striso/striso_duet/README.md

# Striso duet

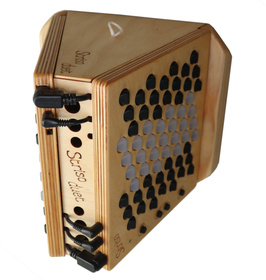
[picture p1: img/duet_complete.jpg]
Striso duet


The Striso duet – a portable instrument based on the Striso board, inspired by concertina, bandoneon and accordion. This repository contains the design files and assembly instructions. For more information on the instrument see the https://www.striso.org/the-striso-duet/.

To encourage the design of custom instruments based on the Striso board the design files of the Striso duet are released as open source under the CERN Open Hardware Licence. We'd love to hear about your build experience, modifications or custom designs.

## Design
The duet is a wooden body on which two Striso boards can be mounted to play with two hands in a concertina/bandoneon/accordion style. The body is made from 3mm birch multiplex and the design is cut and engraved with a laser cutter.

The laser cutting design is made in [Inkscape](www.inkscape.org), and is currently optimized for cutting almost 4 duets out of a 67x67cm 3mm multiplex board. For cutting one duet you should reposition the parts. The black lines are cut, the blue lines are engraved, and the green lines are engraved out of focus, to have thicker lines.

The PCBs are designed in EasyEDA. (Normally I'd use KiCAD, but for these simple PCBs I was drawn to EasyEDA for its integrated fabrication service and related parts library).

## Assembly guide
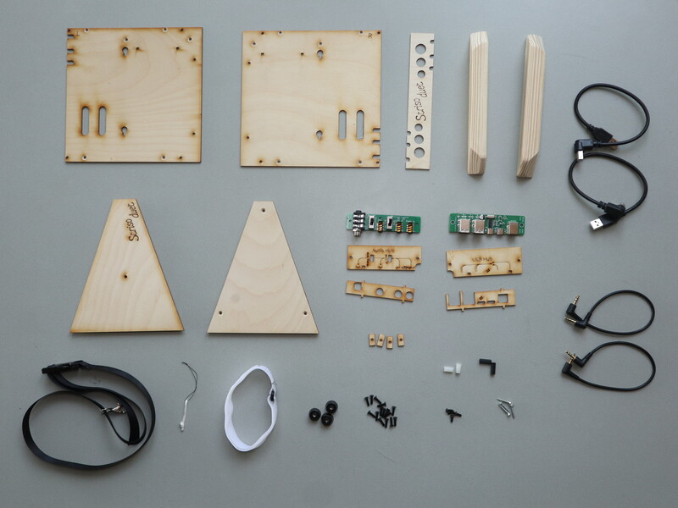
[picture p2: img/duet_kit.jpg]
Duet parts


#### Part list:
- Lasercut parts: 2 sides, front, top, bottom, USB and audio PCB covers, PCB spacers. Top and bottom parts consist of 3 layers glued together.
- Palm rests: 22x30x194mm wood with chamfered corners and rounded edge
- Audio mixer hub PCB
- USB hub PCB
- 3x rubber feet (with 3mm flange nut inside)
- 15x M3 12mm countersunk hex screw
- 4x M3 8mm mushroom hex screw
- 2x M3 20mm standoff
- 2x M3 12mm standoff
- 4x 3mm wood screw
- 8x M3 square nut (already inserted in top and bottom panels while glueing) (hex nuts probably work fine too)
- 2x 20cm right angled USB-B cable
- 2x 20cm right angled 3.5mm jack cable
- Strap connection loop
- Neck strap
- Velcro strap for holding speaker or powerbank

#### Assembly steps
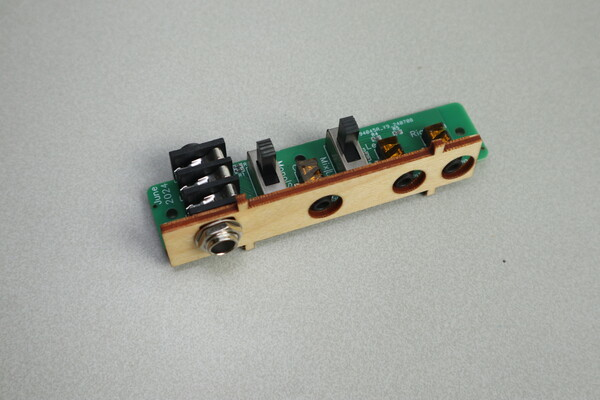
[picture p3: img/1.jpg]
\
Put the front panel on the audio PCB

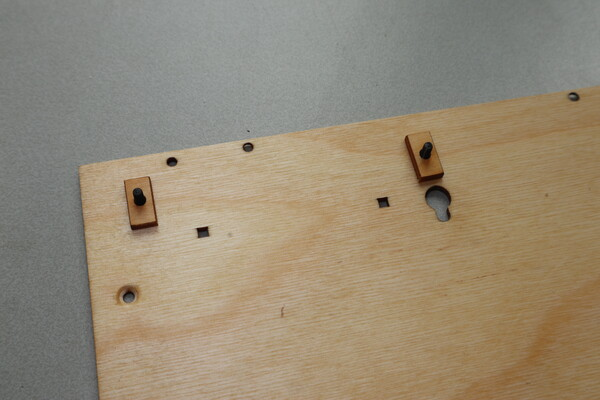
[picture p4: img/3.jpg]
\
Put 2 screws through the left side and add PCB spacers

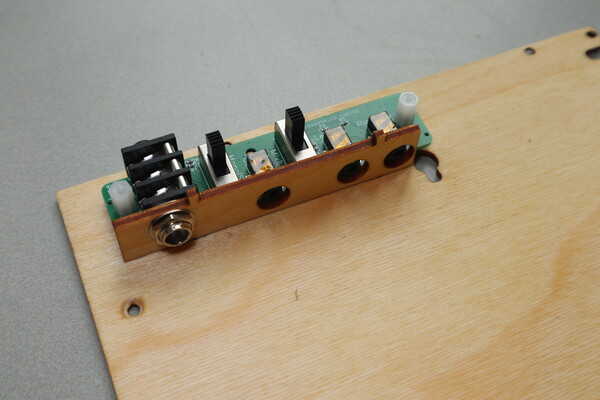
[picture p5: img/4.jpg]
\
Put the audio PCB assembly on top and fix it with 12mm standoffs

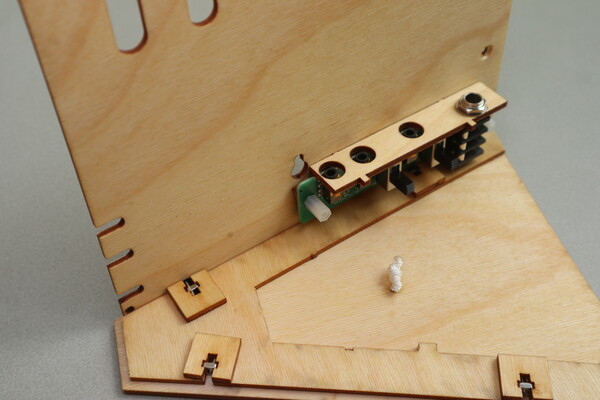
[picture p6: img/5.jpg]
\
Attach the top panel with 2 screws

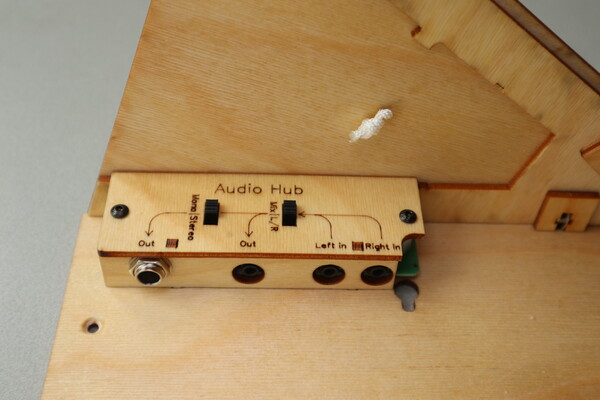
[picture p7: img/6.jpg]
\
Put the top panel on the audio PCB and fix with two M3 mushroom screws

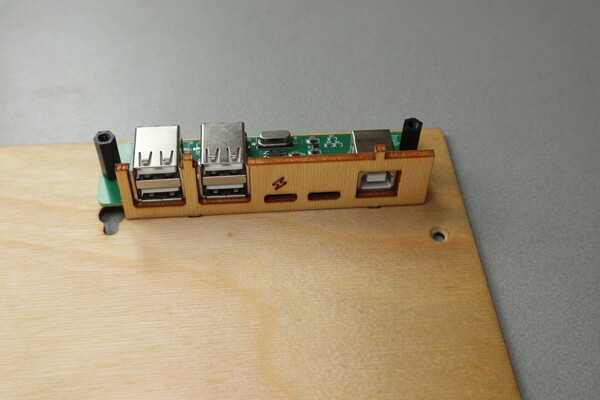
[picture p8: img/7.jpg]
 \
Repeat these steps for the USB PCB on the other side

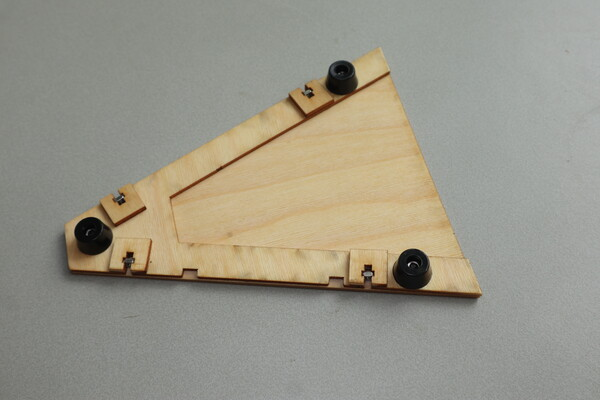
[picture p9: img/9.jpg]
\
Attach the rubber feet with 3 screws

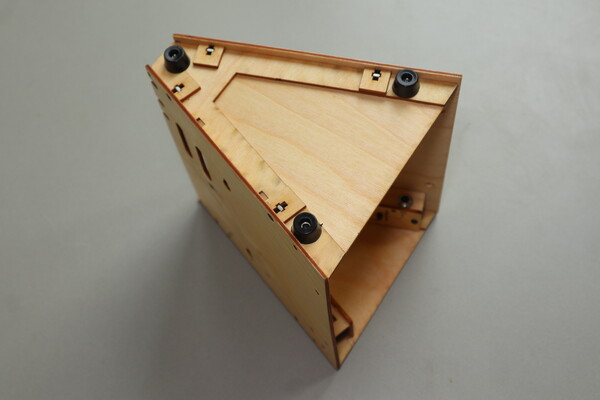
[picture p10: img/10.jpg]
\
Attach the bottom panel with 4 screws

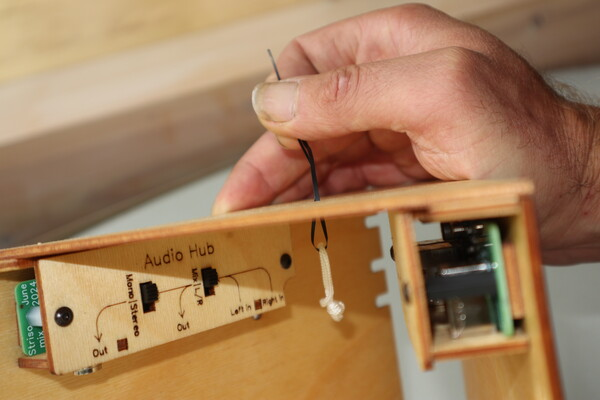
[picture p11: img/11.jpg]
 \
Pull the neck strap loop trough the top hole with a thin thread

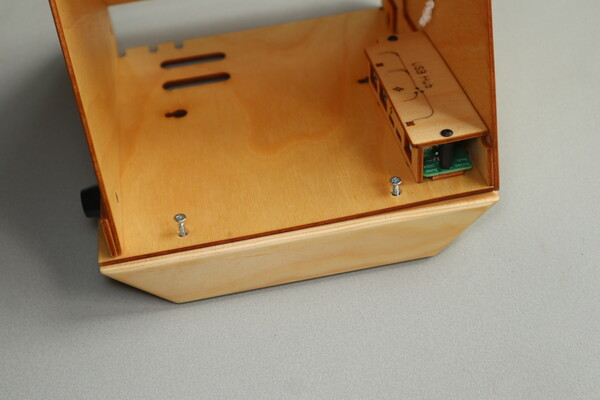
[picture p12: img/13.jpg]
\
Attach the palm rests with the wood screws

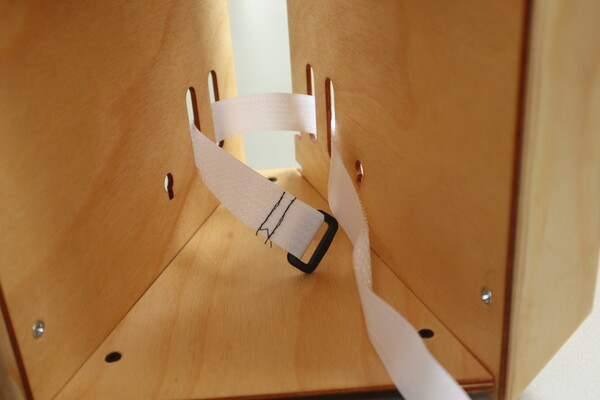
[picture p13: img/14.jpg]
\
Put the velcro strap through the slits

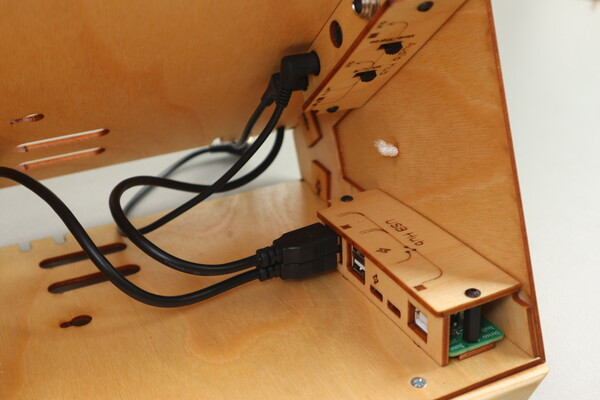
[picture p14: img/15.jpg]
\
Put the USB and audio cable in the hubs

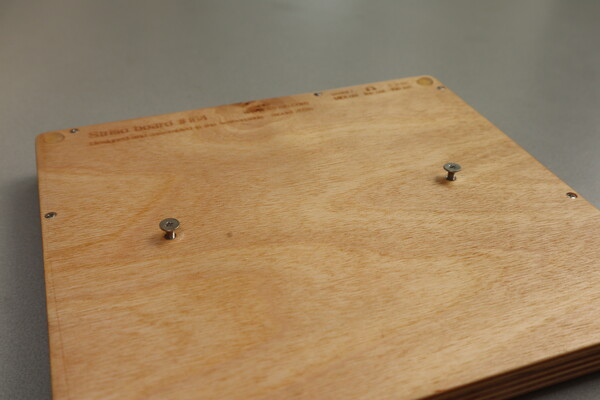
[picture p15: img/17.jpg]
\
Loosen the mounting screws on the back of the Striso board. Be careful to not push too hard on the loosened screws, otherwise the nuts can go inside the Striso board!

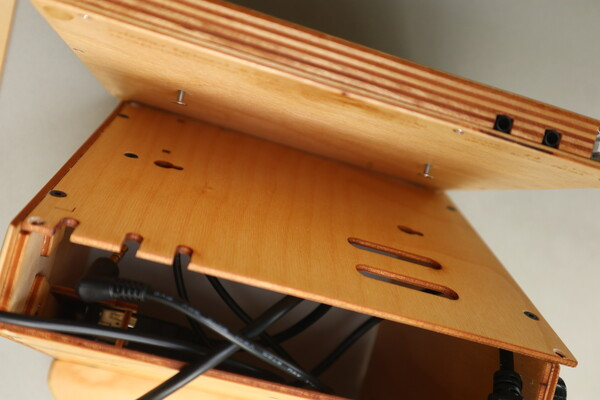
[picture p16: img/18.jpg]
\
Slide them into the keyholes and tighten them with a small philips screwdriver (PH1) (or just a bit in a bitholder)

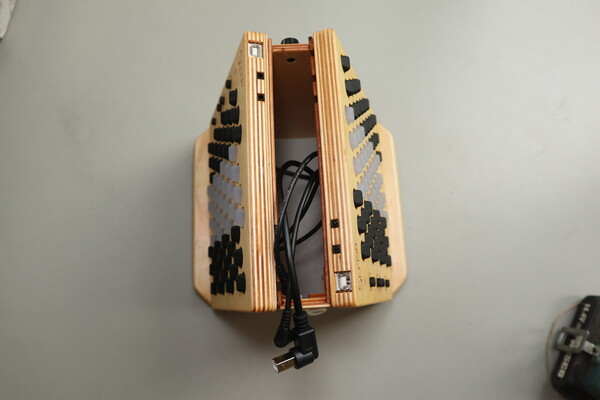
[picture p17: img/19.jpg]
\
Repeat for the second Striso board

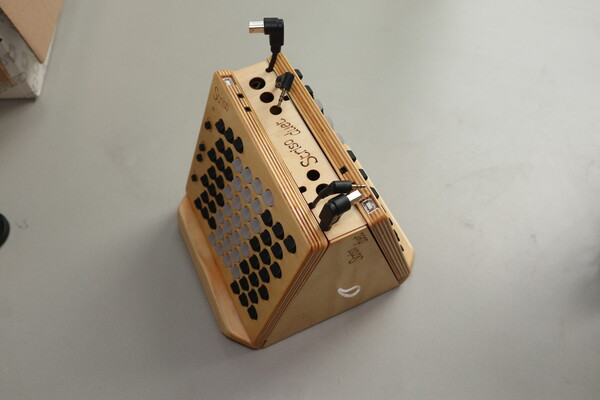
[picture p18: img/20.jpg]
\
Put the front into place with the cables through the holes

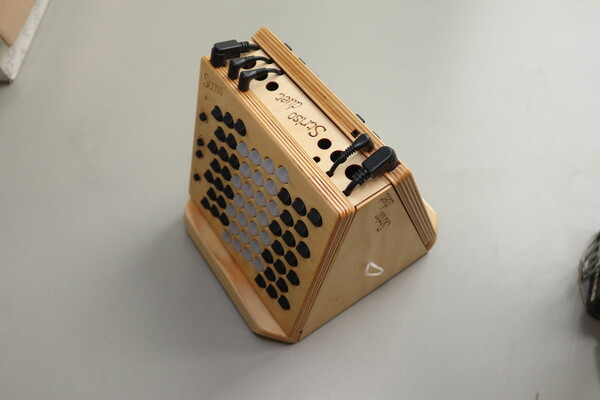
[picture p19: img/21.jpg]
\
Insert the cables in the Striso boards, this also holds the front in place. (In this picture the alternative audio routing is used)

Good luck!
