striso/striso_duet/img/8.jpg

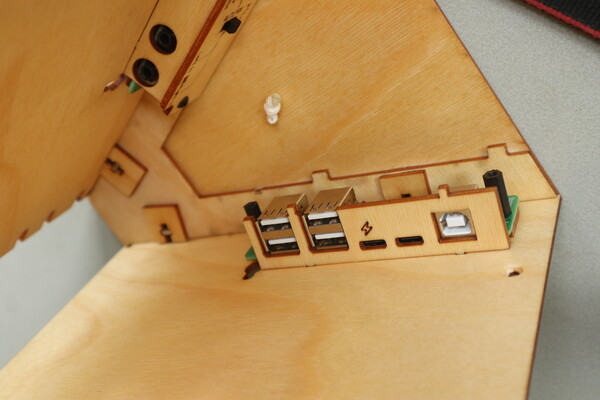
img/8.jpg
