striso/striso_duet/img/12.jpg

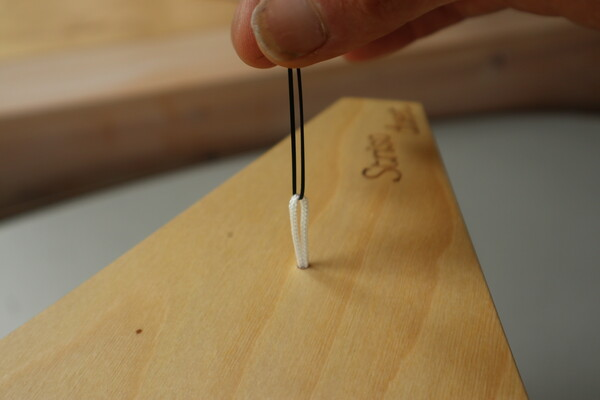
img/12.jpg
