striso/striso_duet/(list of files, drawings)

Other design files:
pcb/Striso_audio_mixer.epro
pcb/Striso_USB_hub.epro
