striso/striso_duet/(commit log)

2025-02-19 Add pcbs
    [Striso_USB_hub.epro, Striso_audio_mixer.epro]
2025-02-19 USB hub PCB update with less capacitors
    [Striso_USB_hub.epro]
